ealex/bq76920_board/hardware/bq76920_simple_balance/bq76920_bot.jpg

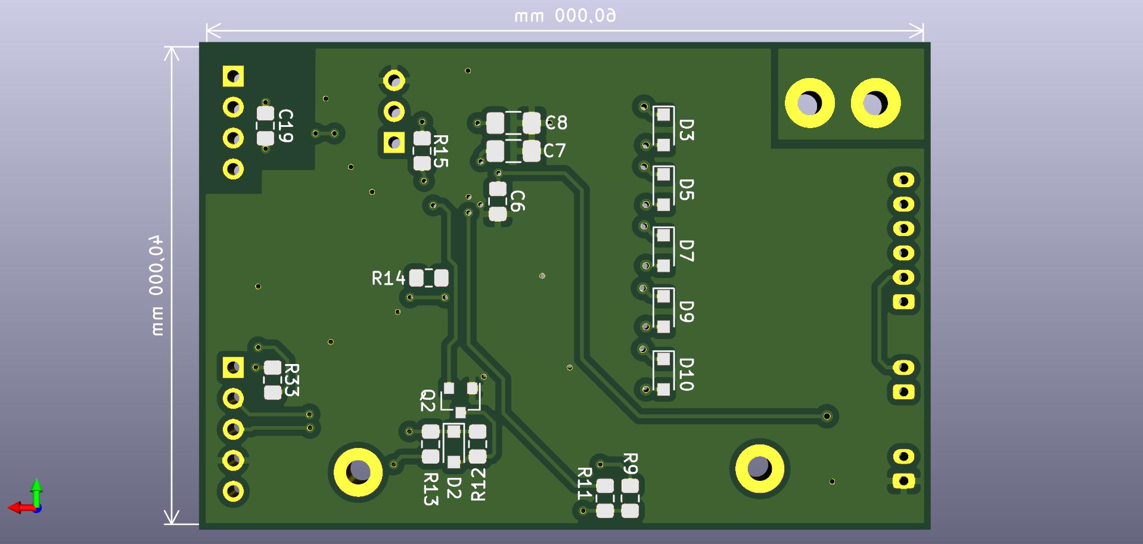
hardware/bq76920_simple_balance/bq76920_bot.jpg
