ealex/bq76920_board/hardware/bq76920_simple_balance/bq76920.html

# BOM Rev

Date

Company

Comment 1

Comment 2

Comment 3

Comment 4

Total Parts

# 86 (Unique 31)

Ref

Qty

Value

Footprint

Datasheet

[C] -

C1 C2 C3

3

100n

Capacitor_SMD:C_0805_2012Metric_Pad1.15x1.40mm_HandSolder

~

C4 C6 C18

3

1n

Capacitor_SMD:C_0805_2012Metric_Pad1.15x1.40mm_HandSolder

~

C5 C7 C8

3

C1206C475K5RACTU

Capacitor_SMD:C_1206_3216Metric_Pad1.42x1.75mm_HandSolder

~

C9 C16 C17 C19

4

100nF

Capacitor_SMD:C_0805_2012Metric_Pad1.15x1.40mm_HandSolder

~

C10 C11 C12 C13 C14 C15

6

220n

Capacitor_SMD:C_0805_2012Metric_Pad1.15x1.40mm_HandSolder

~

[D] -

D1 D2

2

PMEG3010BEA,115

Diode_SMD:D_SOD-323_HandSoldering

https://assets.nexperia.com/documents/data-sheet/1N4148_1N4448.pdf

D3 D5 D7 D9 D10

5

MM3Z5V6ST1G

Diode_SMD:D_SOD-323_HandSoldering

~

D11 D12 D13

3

APTD3216SURCK

Capacitor_SMD:C_1206_3216Metric_Pad1.42x1.75mm_HandSolder

~

[J] -

J1

1

BAT+

bq76920:power_pin

~

J2

1

Conn_01x06

Connector_JST:JST_PH_B6B-PH-K_1x06_P2.00mm_Vertical

~

J3

1

therm

Connector_JST:JST_PH_B2B-PH-K_1x02_P2.00mm_Vertical

~

J4

1

boot_switch

Connector_JST:JST_PH_B2B-PH-K_1x02_P2.00mm_Vertical

~

J5

1

BAT-

bq76920:power_pin

~

J6

1

PACK+

bq76920:power_pin

~

J7

1

PACK-

bq76920:power_pin

~

J8

1

Conn_01x04

Connector_PinHeader_2.54mm:PinHeader_1x04_P2.54mm_Vertical

~

J9

1

Conn_01x05

Connector_PinHeader_2.54mm:PinHeader_1x05_P2.54mm_Vertical

~

J10

1

Conn_01x03

Connector_PinHeader_2.54mm:PinHeader_1x03_P2.54mm_Vertical

~

[Q] -

Q1 Q3

2

PSMN2R6-40YS

Package_TO_SOT_SMD:LFPAK56

Q2

1

SI2337DS-T1-E3

Package_TO_SOT_SMD:SOT-23

~

Q4 Q5 Q6 Q7 Q8

5

NTR3C21NZ

Package_TO_SOT_SMD:SOT-23

~

[R] -

R1 R2 R4 R11 R14 R15 R22 R24 R26 R28 R30 R32 R33 R34 R35 R36

16

10k

Resistor_SMD:R_0805_2012Metric_Pad1.15x1.40mm_HandSolder

~

R3 R6 R8 R10

4

100

Resistor_SMD:R_0805_2012Metric_Pad1.15x1.40mm_HandSolder

~

R5

1

WSHP28185L000FEA

bq76920:WSHP28185L000FEA

~

R7

1

500k

Resistor_SMD:R_0805_2012Metric_Pad1.15x1.40mm_HandSolder

~

R9 R12 R13

3

1Meg

Resistor_SMD:R_0805_2012Metric_Pad1.15x1.40mm_HandSolder

~

R16 R17 R18 R19 R20

5

100

Resistor_SMD:R_1206_3216Metric_Pad1.42x1.75mm_HandSolder

~

R21 R23 R25 R27 R29 R31

6

1k

Resistor_SMD:R_0805_2012Metric_Pad1.15x1.40mm_HandSolder

~

[U] -

U1

1

bq76920

Package_SO:TSSOP-20_4.4x6.5mm_P0.65mm

U2

1

ISO7021

Package_SO:SOIC-8_3.9x4.9mm_P1.27mm

U3

1

STM32L031F4Px

Package_SO:TSSOP-20_4.4x6.5mm_P0.65mm

http://www.st.com/st-web-ui/static/active/en/resource/technical/document/datasheet/DM00140359.pdf

# BOM made with KICAD_BOM_WIZARD (https://github.com/HashDefineElectronics/KiCad_BOM_Wizard) (Generated Mon 03 Feb 2020 01:59:52 PM EET)
