ealex/bq76920_board/documentation/bq769xx/Schematic_10s-Batt-Management-with-Balancing_10s-Batt-Manager-with-on-board-Balancing_20190723125838.pdf

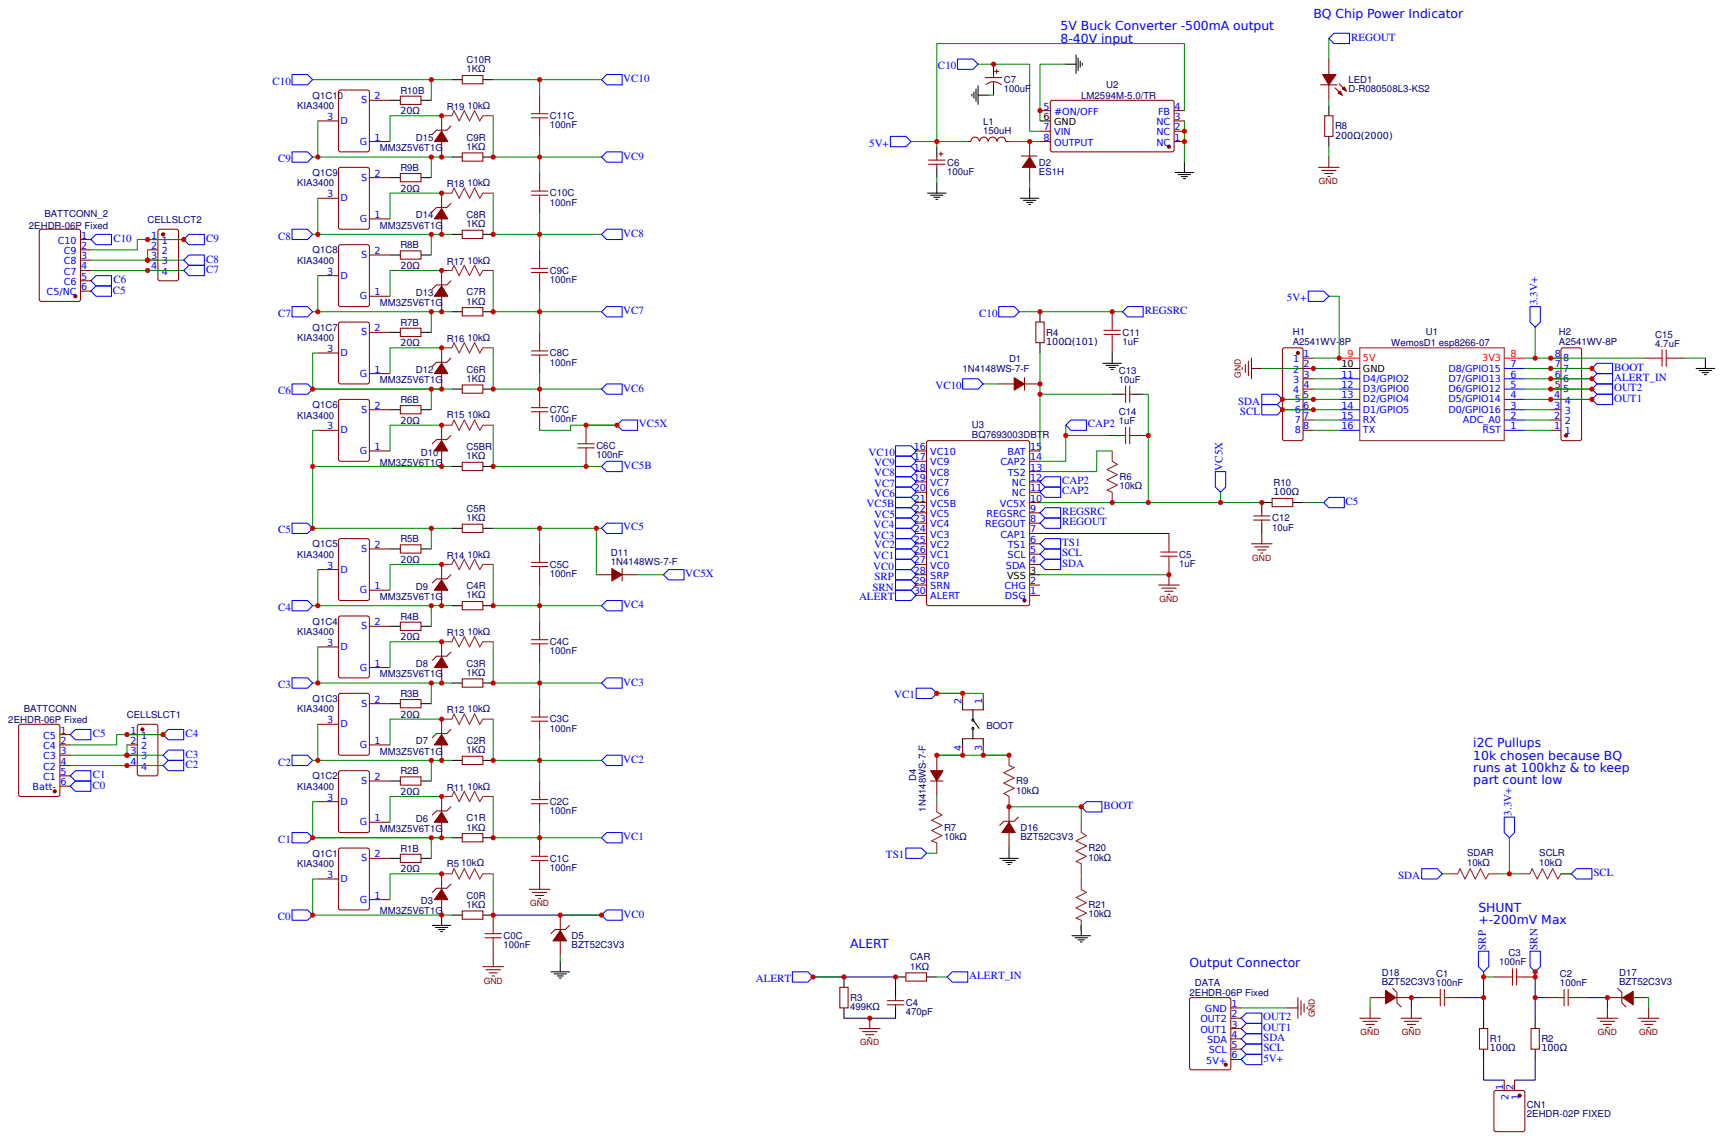
[picture p3: page 1]

BQ Chip Power Indicator
REGOUT

NC 1 NC 2 NC 3 FB 4 #ON/OFF 5
GND 6
VIN 7

i2C Pullups
10k chosen because BQ
runs at 100khz & to keep
part count low
