ealex/bq76920_board/hardware/bq76920_simple_balance/bq76920.pdf

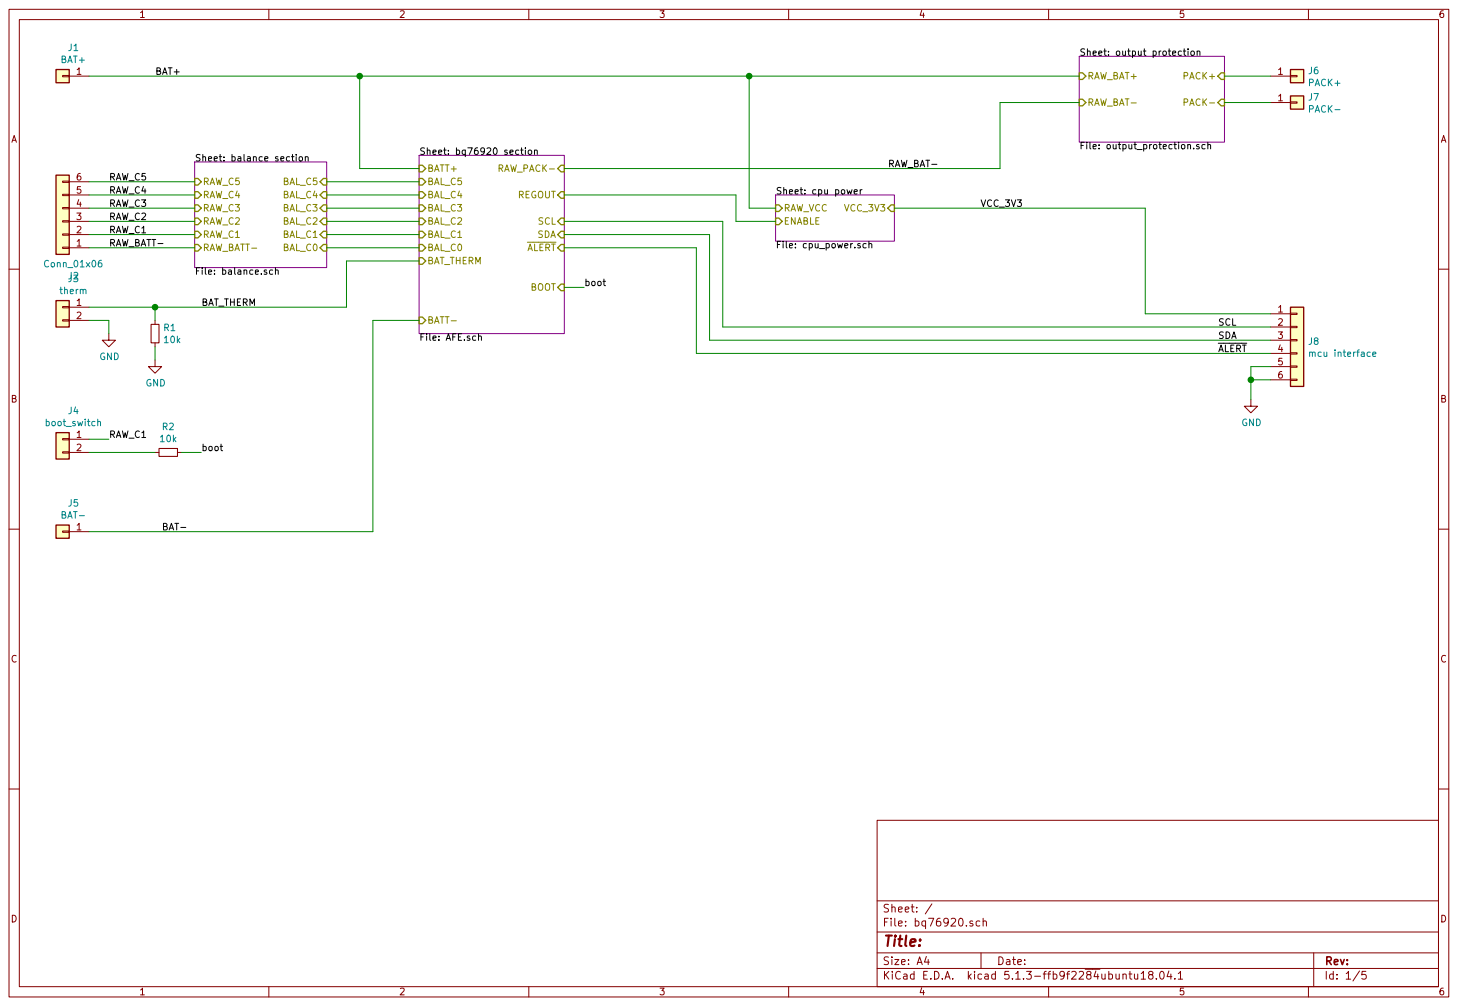
[picture p4: page 1]

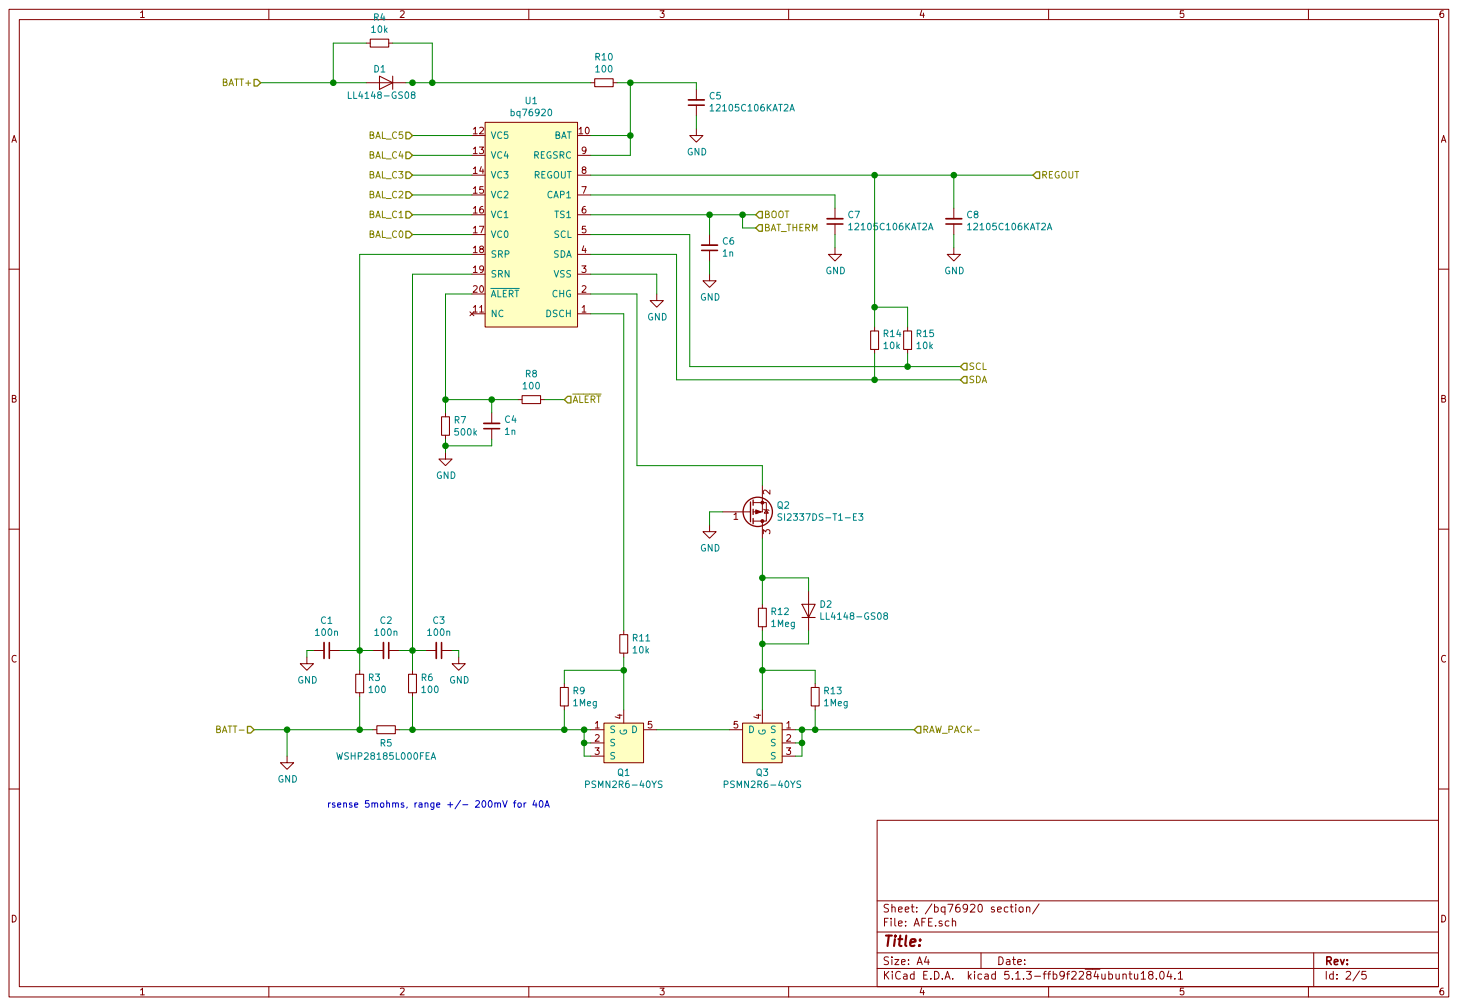
[picture p5: page 2]

Id: 2/5 Title: File: AFE.sch Sheet: /bq76920 section/ GND

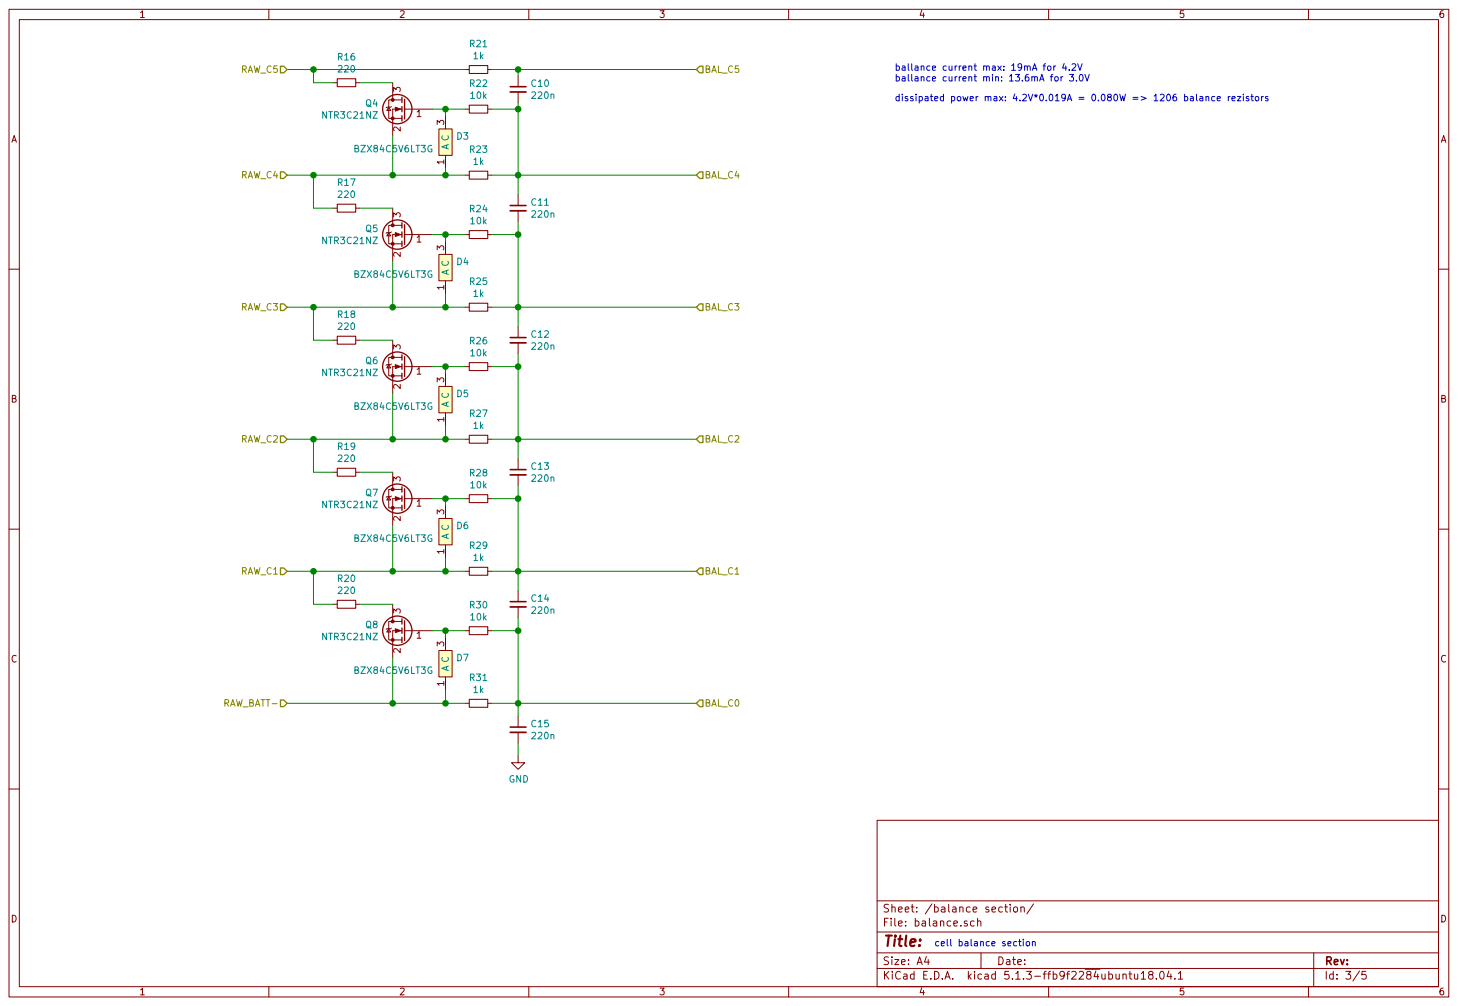
[picture p6: page 3]

dissipated power max: 4.2V*0.019A = 0.080W => 1206 balance rezistors ballance current max: 19mA for 4.2V
ballance current min: 13.6mA for 3.0V

Id: 3/5 Title: File: balance.sch Sheet: /balance section/ C13

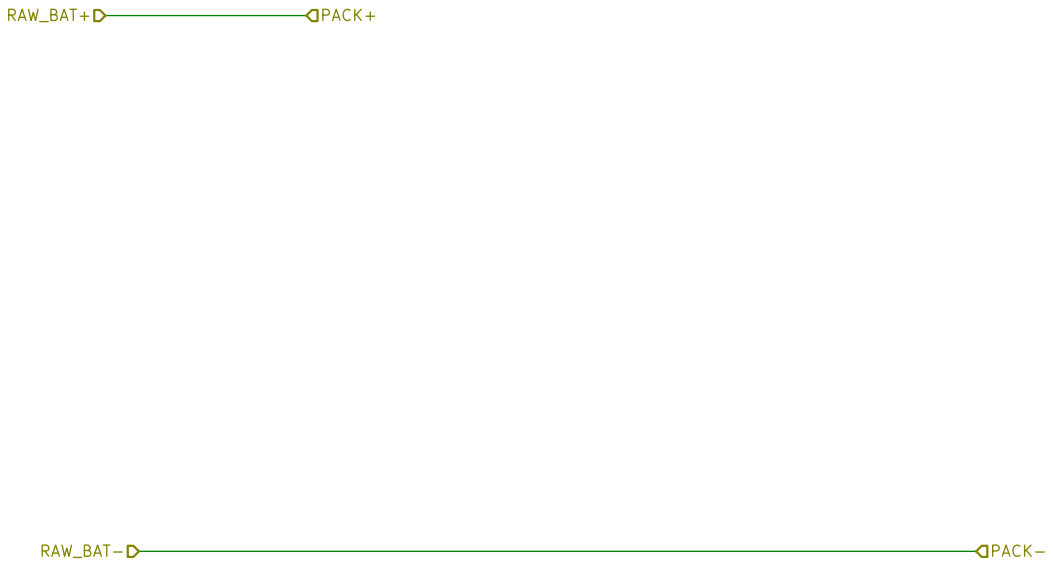
[picture p7: page 4]

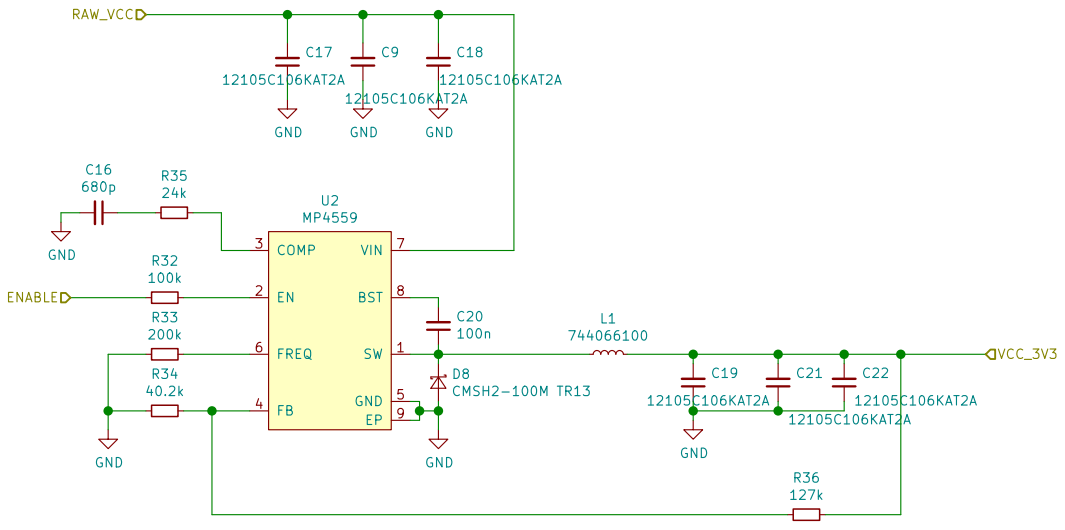
[picture p8: page 5]
