ealex/bq76920_board/hardware/bq76920_simple_balance/bq76920.kicad_pcb

## KiCad design hardware/bq76920_simple_balance/bq76920.kicad_pcb (2021-12-02)

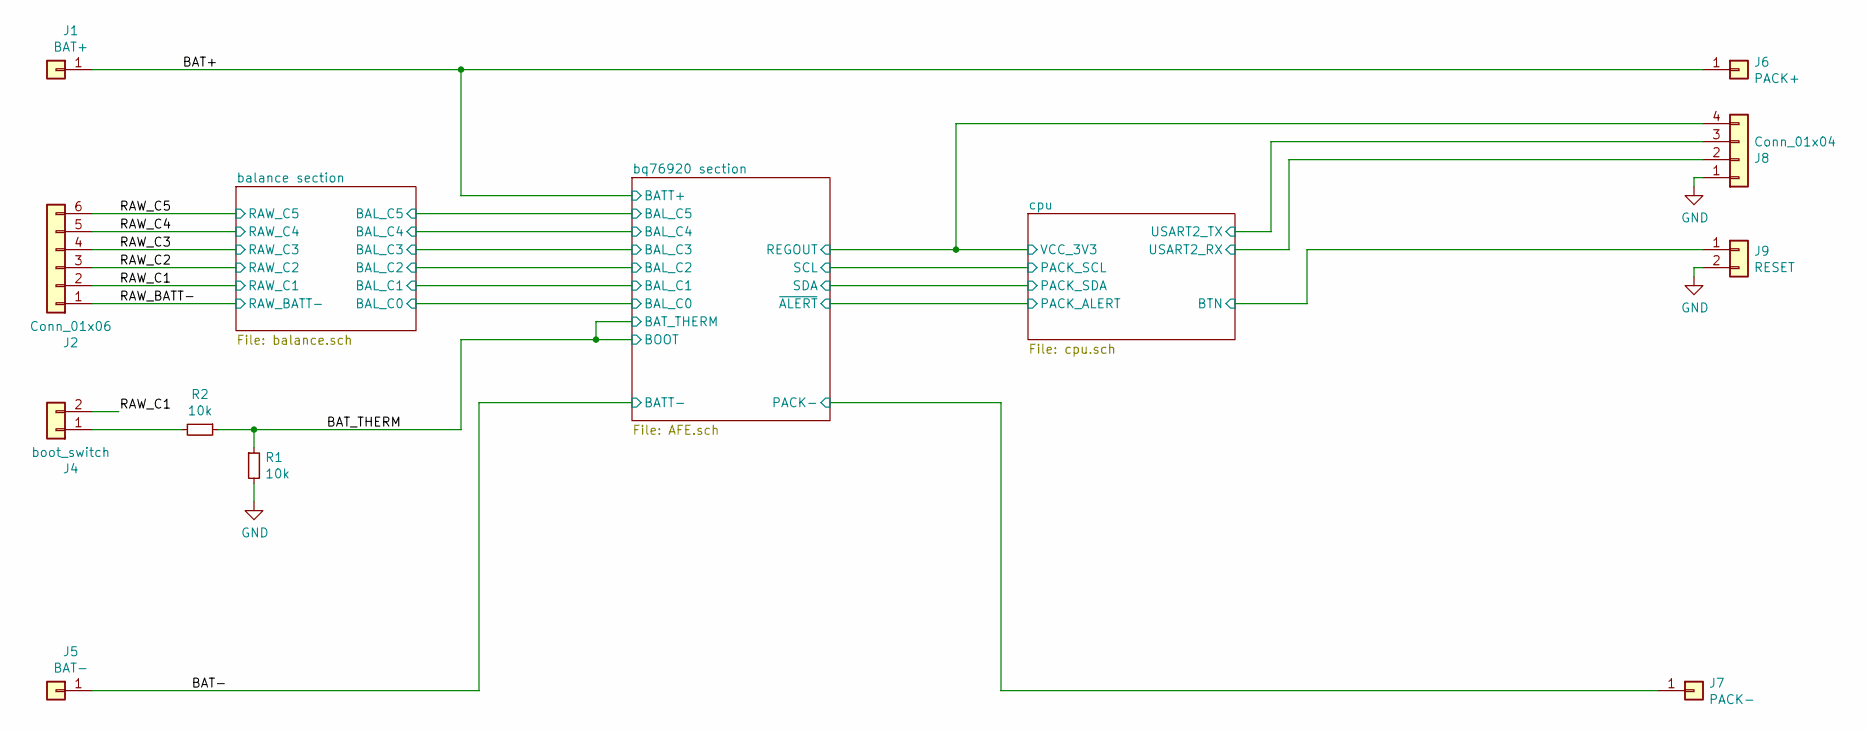
[picture p9: schematic bq76920.sch]

Parts:
J1: BAT+; power_pin
J2: Conn_01x06; JST_PH_B6B-PH-K_1x06_P2.00mm_Vertical
J4: boot_switch; JST_PH_B2B-PH-K_1x02_P2.00mm_Vertical
J5: BAT-; power_pin
J6: PACK+; power_pin
J7: PACK-; power_pin
J8: Conn_01x04; JST_PH_B4B-PH-K_1x04_P2.00mm_Vertical
J9: RESET; JST_PH_B2B-PH-K_1x02_P2.00mm_Vertical
R1, R2: 10k; R_0805_2012Metric_Pad1.15x1.40mm_HandSolder

Connections:
+3V3: J8.4; also elsewhere on the board
/BAT+: J1.1, J6.1; also elsewhere on the board
/BAT-: J5.1; also elsewhere on the board
/BAT_THERM: R1.1, R2.1; also elsewhere on the board
/RAW_BATT-: J2.1; also elsewhere on the board
/RAW_C1: J2.2, J4.2; also elsewhere on the board
/RAW_C2: J2.3; also elsewhere on the board
/RAW_C3: J2.4; also elsewhere on the board
/RAW_C4: J2.5; also elsewhere on the board
/RAW_C5: J2.6; also elsewhere on the board
/bq76920 section/PACK-: J7.1; also elsewhere on the board
/cpu/BTN: J9.1; also elsewhere on the board
/cpu/USART2_RX: J8.2; also elsewhere on the board
/cpu/USART2_TX: J8.3; also elsewhere on the board
GND: J8.1, J9.2, R1.2; also elsewhere on the board
unnamed: J4.1, R2.2

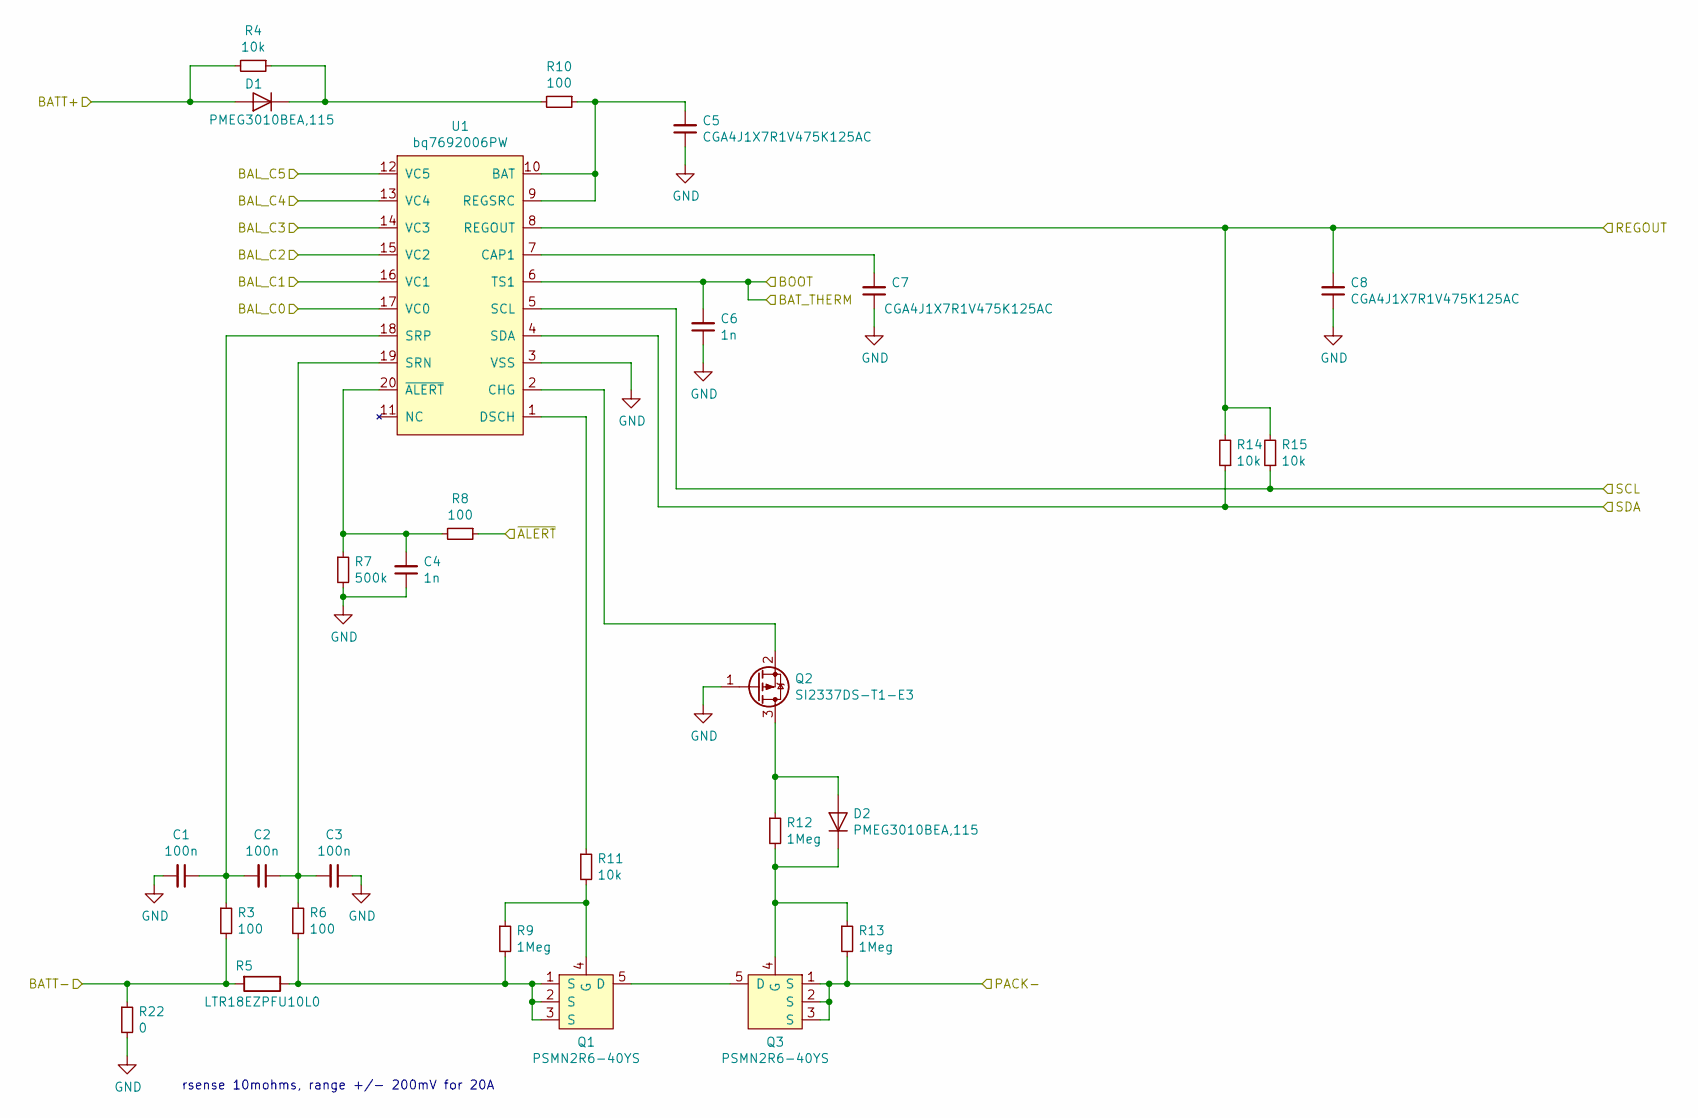
[picture p10: schematic AFE.sch]

Parts:
C1, C2, C3: 100n; C_0805_2012Metric_Pad1.15x1.40mm_HandSolder
C4, C6: 1n; C_0805_2012Metric_Pad1.15x1.40mm_HandSolder
C5, C7, C8: CGA4J1X7R1V475K125AC; C_0805_2012Metric
D1, D2: PMEG3010BEA,115; D_SOD-323_HandSoldering
Q1, Q3: PSMN2R6-40YS; LFPAK56
Q2: SI2337DS-T1-E3; SOT-23
R3, R6, R8, R10: 100; R_0805_2012Metric_Pad1.15x1.40mm_HandSolder
R4, R11, R14, R15: 10k; R_0805_2012Metric_Pad1.15x1.40mm_HandSolder
R5: LTR18EZPFU10L0; R_0612_1632Metric
R7: 500k; R_0805_2012Metric_Pad1.15x1.40mm_HandSolder
R9, R12, R13: 1Meg; R_0805_2012Metric_Pad1.15x1.40mm_HandSolder
R22: 0; R_0805_2012Metric_Pad1.15x1.40mm_HandSolder
U1: bq7692006PW; TSSOP-20_4.4x6.5mm_P0.65mm

Connections:
+3V3: C8.2, R14.2, R15.2, U1.8 (REGOUT); also elsewhere on the board
/BAT+: D1.2 (A), R4.2; also elsewhere on the board
/BAT-: R3.2, R5.2, R22.1; also elsewhere on the board
/BAT_THERM: C6.2, U1.6 (TS1); also elsewhere on the board
/balance section/BAL_C0: U1.17 (VC0); also elsewhere on the board
/balance section/BAL_C1: U1.16 (VC1); also elsewhere on the board
/balance section/BAL_C2: U1.15 (VC2); also elsewhere on the board
/balance section/BAL_C3: U1.14 (VC3); also elsewhere on the board
/balance section/BAL_C4: U1.13 (VC4); also elsewhere on the board
/balance section/BAL_C5: U1.12 (VC5); also elsewhere on the board
/bq76920 section/PACK-: Q3.1 (S), Q3.2 (S), Q3.3 (S), R13.2; also elsewhere on the board
/cpu/PACK_ALERT: R8.1; also elsewhere on the board
/cpu/PACK_SCL: R15.1, U1.5 (SCL); also elsewhere on the board
/cpu/PACK_SDA: R14.1, U1.4 (SDA); also elsewhere on the board
GND: C1.2, C3.1, C4.1, C5.1, C6.1, C7.1, C8.1, Q2.1 (G), R7.2, R22.2, U1.3 (VSS); also elsewhere on the board
unnamed: C1.1, C2.2, R3.1, U1.18 (SRP)
unnamed: C2.1, C3.2, R6.1, U1.19 (SRN)
unnamed: C4.2, R7.1, R8.2, U1.20 (~ALERT)
unnamed: C5.2, R10.1, U1.9 (REGSRC), U1.10 (BAT)
unnamed: C7.2, U1.7 (CAP1)
unnamed: D1.1 (K), R4.1, R10.2
unnamed: D2.1 (K), Q3.4 (G), R12.2, R13.1
unnamed: D2.2 (A), Q2.3 (D), R12.1
unnamed: Q1.1 (S), Q1.2 (S), Q1.3 (S), R5.1, R6.2, R9.2
unnamed: Q1.4 (G), R9.1, R11.2
unnamed: Q1.5 (D), Q3.5 (D)
unnamed: Q2.2 (S), U1.2 (CHG)
unnamed: R11.1, U1.1 (DSCH)

Notes on the sheet:
rsense 10mohms, range +/- 200mV for 20A

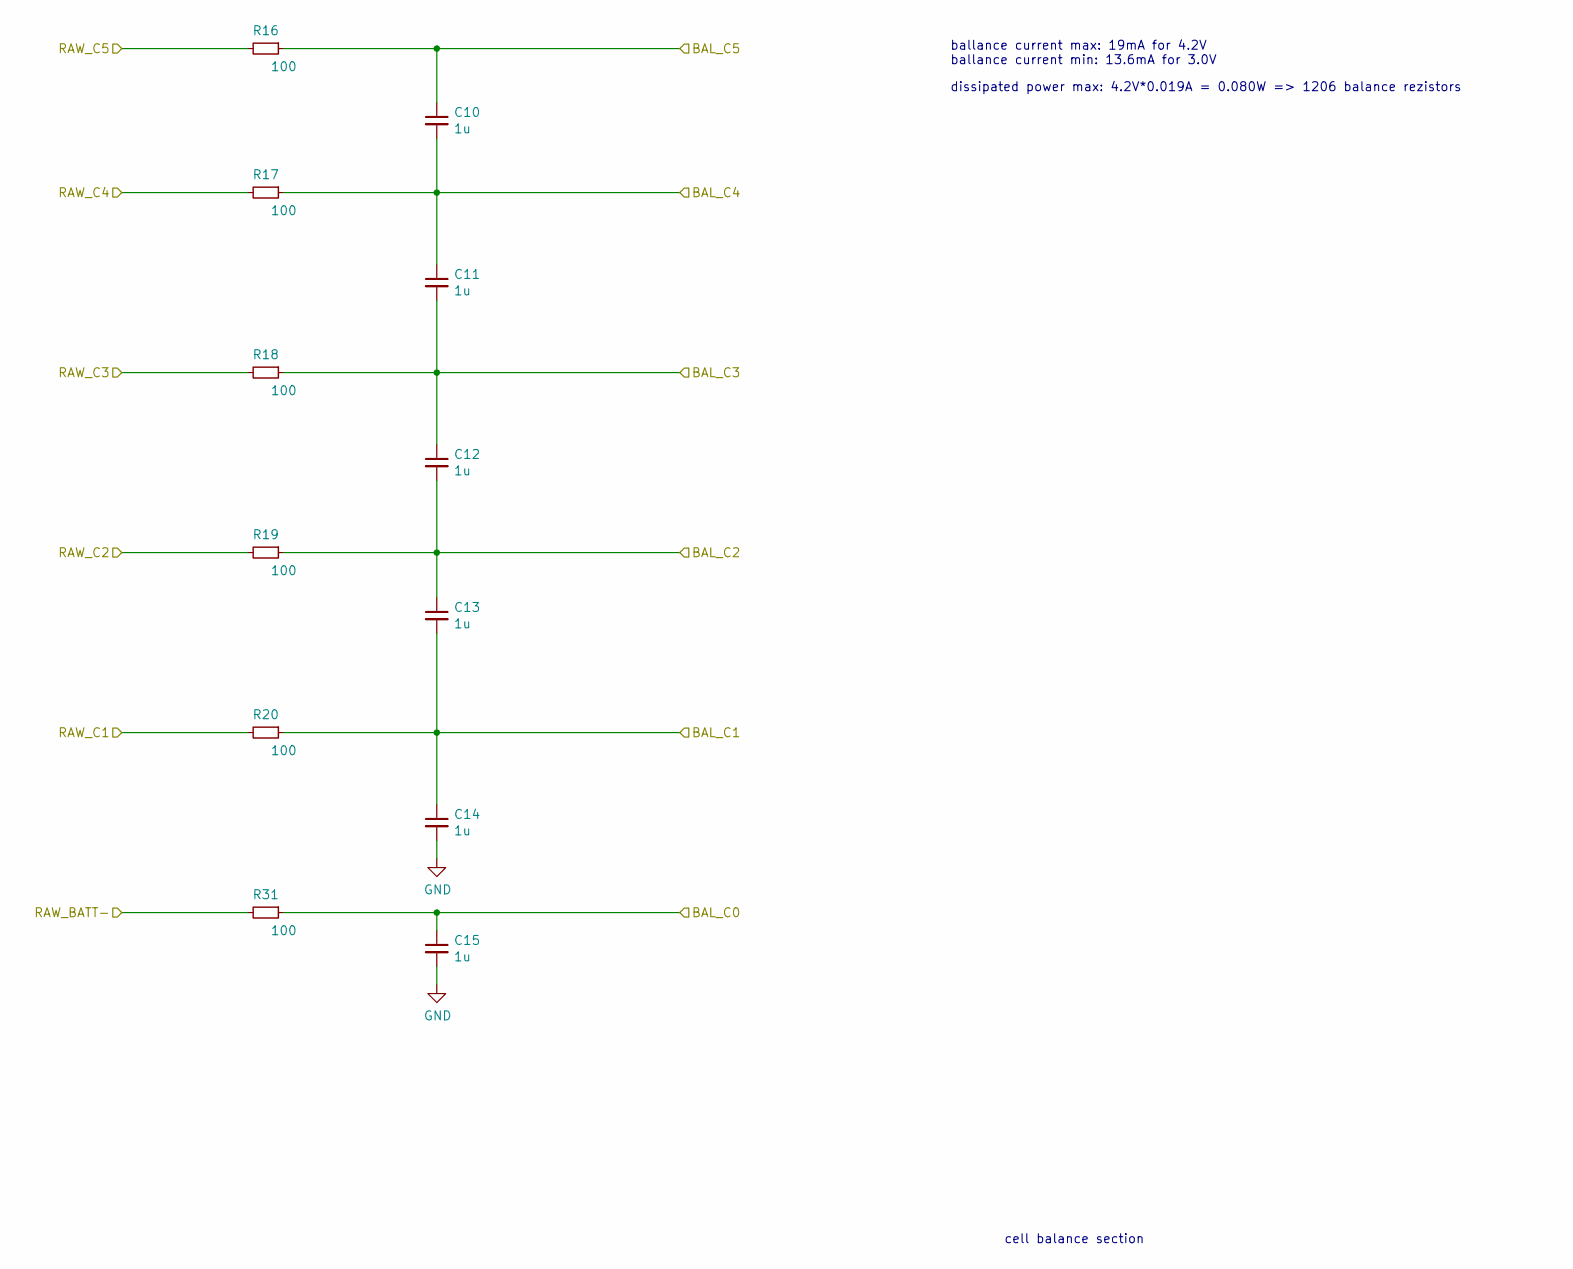
[picture p11: schematic balance.sch]

Parts:
C10, C11, C12, C13, C14, C15: 1u; C_0805_2012Metric_Pad1.15x1.40mm_HandSolder
R16, R17, R18, R19, R20, R31: 100; R_1206_3216Metric

Connections:
/RAW_BATT-: R31.2; also elsewhere on the board
/RAW_C1: R20.2; also elsewhere on the board
/RAW_C2: R19.2; also elsewhere on the board
/RAW_C3: R18.2; also elsewhere on the board
/RAW_C4: R17.2; also elsewhere on the board
/RAW_C5: R16.2; also elsewhere on the board
/balance section/BAL_C0: C15.1, R31.1; also elsewhere on the board
/balance section/BAL_C1: C13.2, C14.1, R20.1; also elsewhere on the board
/balance section/BAL_C2: C12.2, C13.1, R19.1; also elsewhere on the board
/balance section/BAL_C3: C11.2, C12.1, R18.1; also elsewhere on the board
/balance section/BAL_C4: C10.2, C11.1, R17.1; also elsewhere on the board
/balance section/BAL_C5: C10.1, R16.1; also elsewhere on the board
GND: C14.2, C15.2; also elsewhere on the board

Notes on the sheet:
ballance current max: 19mA for 4.2V ballance current min: 13.6mA for 3.0V
dissipated power max: 4.2V*0.019A = 0.080W => 1206 balance rezistors
cell balance section

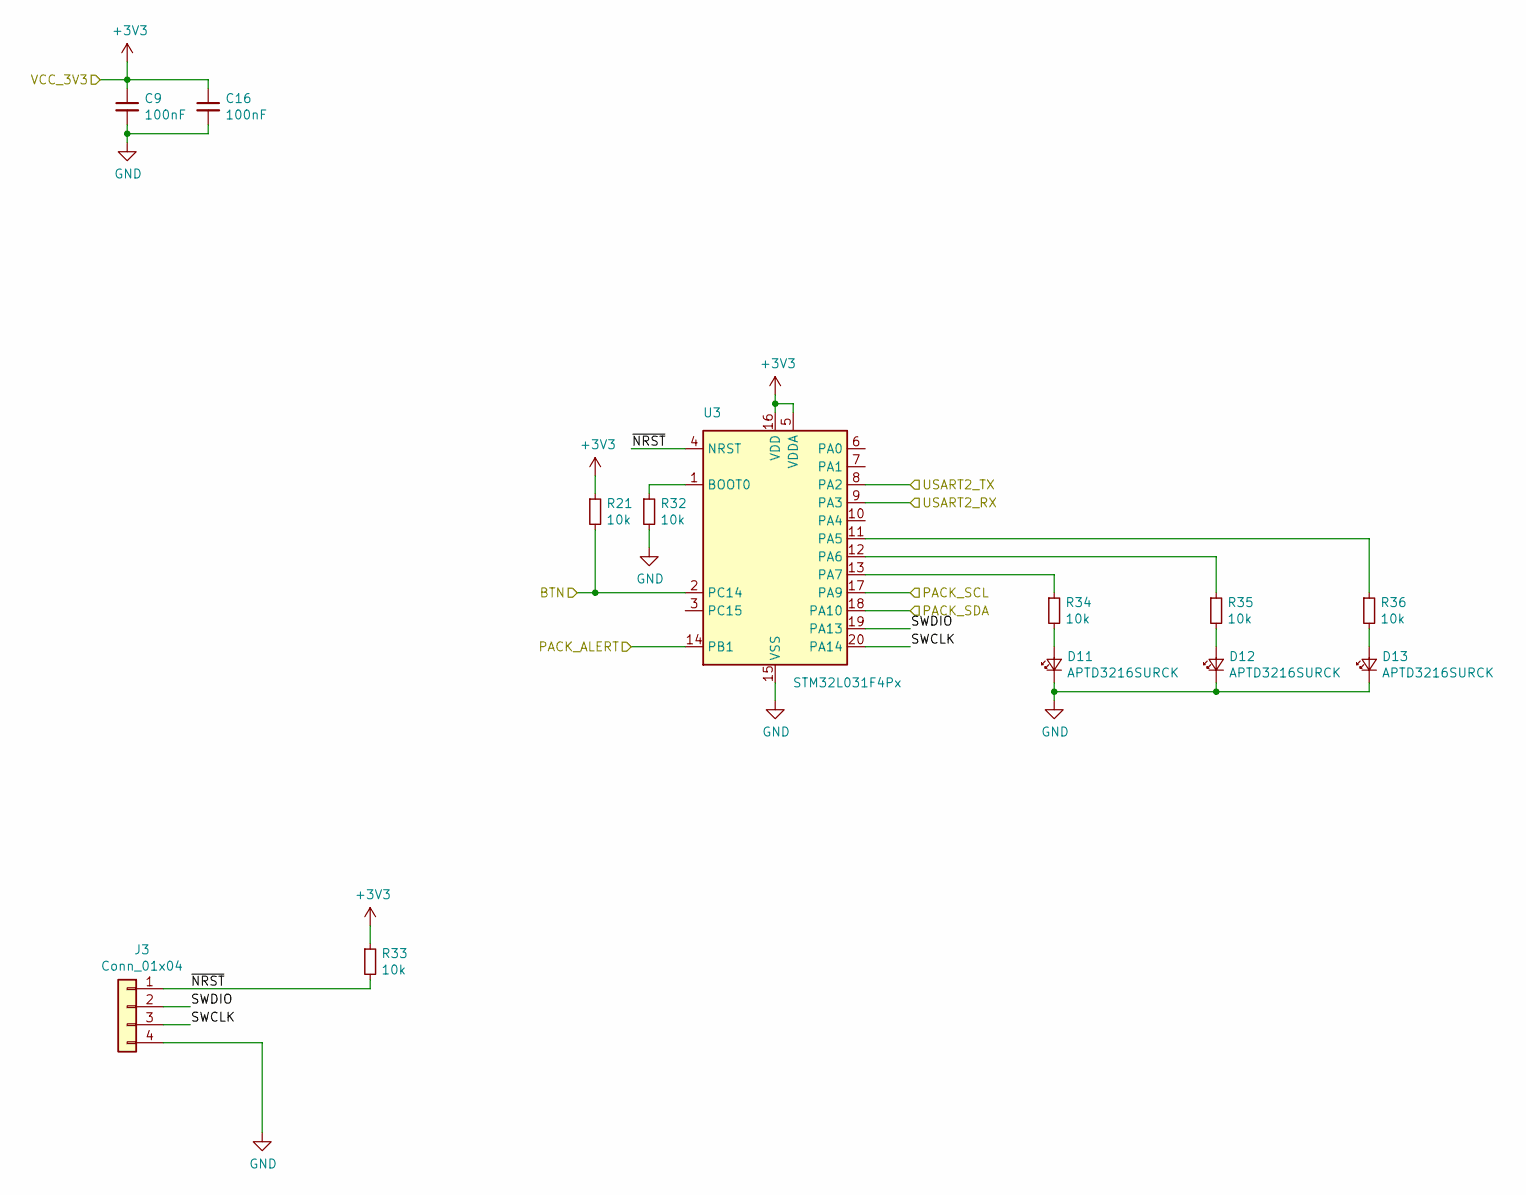
[picture p12: schematic cpu.sch]

Parts:
C9, C16: 100nF; C_0805_2012Metric_Pad1.15x1.40mm_HandSolder
D11, D12, D13: APTD3216SURCK; C_1206_3216Metric_Pad1.42x1.75mm_HandSolder
J3: Conn_01x04; JST_PH_B4B-PH-K_1x04_P2.00mm_Vertical
R21, R32, R33, R34, R35, R36: 10k; R_0805_2012Metric_Pad1.15x1.40mm_HandSolder
U3: STM32L031F4Px; TSSOP-20_4.4x6.5mm_P0.65mm

Connections:
+3V3: C9.1, C16.1, R21.1, R33.1, U3.5 (VDDA), U3.16 (VDD); also elsewhere on the board
/cpu/BTN: R21.2, U3.2 (PC14); also elsewhere on the board
/cpu/PACK_ALERT: U3.14 (PB1); also elsewhere on the board
/cpu/PACK_SCL: U3.17 (PA9); also elsewhere on the board
/cpu/PACK_SDA: U3.18 (PA10); also elsewhere on the board
/cpu/SWCLK: J3.3, U3.20 (PA14)
/cpu/SWDIO: J3.2, U3.19 (PA13)
/cpu/USART2_RX: U3.9 (PA3); also elsewhere on the board
/cpu/USART2_TX: U3.8 (PA2); also elsewhere on the board
/cpu/~NRST: J3.1, R33.2, U3.4 (NRST)
GND: C9.2, C16.2, D11.1 (K), D12.1 (K), D13.1 (K), J3.4, R32.2, U3.15 (VSS); also elsewhere on the board
unnamed: D11.2 (A), R34.2
unnamed: D12.2 (A), R35.2
unnamed: D13.2 (A), R36.2
unnamed: R32.1, U3.1 (BOOT0)
unnamed: R34.1, U3.13 (PA7)
unnamed: R35.1, U3.12 (PA6)
unnamed: R36.1, U3.11 (PA5)

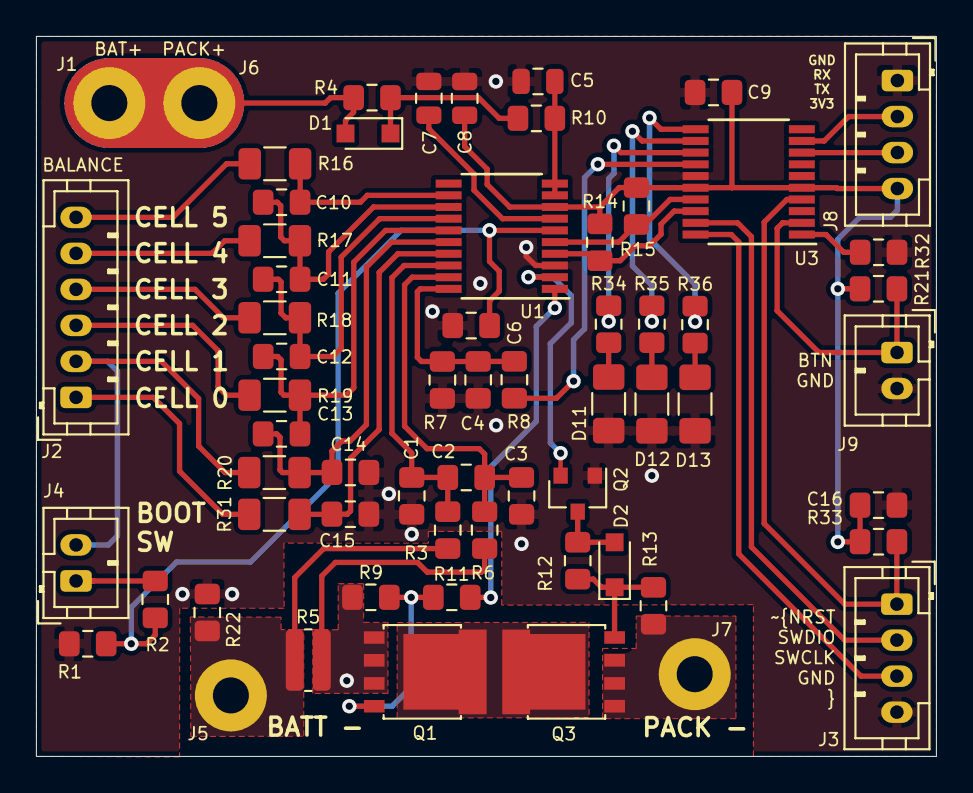
[picture p13: board bq76920.kicad_pcb from above]

Board: 2 copper layers, 50.0 x 40.0 mm, 63 parts (0 on the bottom side), 48 nets.
