ealex/bq76920_board/software/cube/Core/Src/main.c

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
/* Includes ------------------------------------------------------------------*/
#include "main.h"

/* USER CODE BEGIN Includes */
#include "BQ769x0.h"
#include "comm.h"
/* USER CODE END Includes */

/* USER CODE BEGIN PD */
#define BUTTON_DEBOUNCE_LIMIT ((uint32_t)10)
/* USER CODE END PD */


/* USER CODE BEGIN PV */
static afe_config afeConfig;
static condensed_afe_data afeData;
/* USER CODE END PV */

void SystemClock_Config(void);
static void MX_GPIO_Init(void);
static void MX_I2C1_Init(void);
static void MX_USART2_UART_Init(void);
/**
  * @brief  The application entry point.
  * @retval int
  */
int main(void)
{
  /* USER CODE BEGIN 1 */
	uint32_t button_debounce;


  /* USER CODE END 1 */

  /* MCU Configuration--------------------------------------------------------*/

  /* Reset of all peripherals, Initializes the Flash interface and the Systick. */

  LL_APB2_GRP1_EnableClock(LL_APB2_GRP1_PERIPH_SYSCFG);
  LL_APB1_GRP1_EnableClock(LL_APB1_GRP1_PERIPH_PWR);

  /* System interrupt init*/

  /* Configure the system clock */
  SystemClock_Config();

  /* Initialize all configured peripherals */
  MX_GPIO_Init();
  MX_I2C1_Init();
  MX_USART2_UART_Init();
  /* USER CODE BEGIN 2 */

  afeConfig.enabled_cells=0b00010111;
  // current limit settings
  afeConfig.range = threshold_upper;
  afeConfig.sc_delay = scd_400_us;
  afeConfig.sc_voltage=scd_111_56_mv;
  afeConfig.oc_delay=ocd_8_ms;
  afeConfig.oc_voltage=ocd_44_22_mv;
  afeConfig.shuntValue=5; // 5 mOhms
  afeConfig.chargeCurrent_mA = 4000;

  // voltage limit settings
  afeConfig.uv_delay=uvd_4_s;
  afeConfig.uvLimit=0xFF;
  afeConfig.ov_delay=ovd_2_s;
  afeConfig.ovLimit=0xAA;

  // generic pack configuration
  afeConfig.pack_max_voltage = 16400;
  afeConfig.cell_bal_voltage = 4100;

  if(0==bqInit(I2C1, &afeData, &afeConfig)) {
	  // ERROR
	  LL_GPIO_SetOutputPin(LED0_GPIO_Port, LED0_Pin);
	  LL_GPIO_SetOutputPin(LED1_GPIO_Port, LED1_Pin);
	  LL_GPIO_SetOutputPin(LED2_GPIO_Port, LED2_Pin);
	  asm volatile ("bkpt 0");
  } else {
	  bqEnableAll();
  }

  commInit(USART2, &afeData, &afeConfig);
  /* USER CODE END 2 */

  /* Infinite loop */
  /* USER CODE BEGIN WHILE */
  while (1) {
    /* USER CODE END WHILE */

    /* USER CODE BEGIN 3 */
	  // handle AFE
	  if(LL_GPIO_IsInputPinSet(SIGNAL_GPIO_Port,SIGNAL_Pin)) {
		  LL_GPIO_SetOutputPin(LED0_GPIO_Port, LED0_Pin);

		  // AFE event signaled,
		  bqAct();
		  LL_GPIO_ResetOutputPin(LED1_GPIO_Port, LED1_Pin);
		  LL_GPIO_ResetOutputPin(LED2_GPIO_Port, LED2_Pin);
		  if(0b00001100&afeData.status_reg) { // voltage problem
			  LL_GPIO_SetOutputPin(LED1_GPIO_Port, LED1_Pin);
		  } else if(0b00000011&afeData.status_reg) { // discharge current problem
			  LL_GPIO_SetOutputPin(LED2_GPIO_Port, LED2_Pin);
		  } else if (0b11000000&afeData.status_reg) { // charge current problem
			  LL_GPIO_SetOutputPin(LED1_GPIO_Port, LED1_Pin);
			  LL_GPIO_SetOutputPin(LED2_GPIO_Port, LED2_Pin);
		  }

		  // handle the balancing system
		  bqBalance();

		  // handle the communication system
		  commAct();

		  // check the button and decide what needs to happen
		  if(LL_GPIO_IsInputPinSet(BUTTON_GPIO_Port, BUTTON_Pin)) {
			  button_debounce = 0;
		  } else {
			  if(button_debounce < BUTTON_DEBOUNCE_LIMIT) {
				  button_debounce ++;
			  } else if ( BUTTON_DEBOUNCE_LIMIT == button_debounce ) {
				  button_debounce ++;
				  // act on the button
				  if(0b11001111&afeData.status_reg) {
					  // reset error status if there's a problem
					  bqDisableAll();
					  bqResetStatus();
					  bqEnableAll();
				  } else {
					  // start the balance algo
					  afeData.balStatus=1;
				  }
			  } else {
				  button_debounce = button_debounce ;
			  }
		  }

		  LL_GPIO_ResetOutputPin(LED0_GPIO_Port, LED0_Pin);
	  }
  }
  /* USER CODE END 3 */
}

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
