ealex/bq76920_board/software/cube/Core/Inc/main.h

#define BUTTON_Pin LL_GPIO_PIN_14
#define BUTTON_GPIO_Port GPIOC
#define LED2_Pin LL_GPIO_PIN_4
#define LED2_GPIO_Port GPIOA
#define LED0_Pin LL_GPIO_PIN_5
#define LED0_GPIO_Port GPIOA
#define LED1_Pin LL_GPIO_PIN_6
#define LED1_GPIO_Port GPIOA
#define SIGNAL_Pin LL_GPIO_PIN_1
#define SIGNAL_GPIO_Port GPIOB
#define NVIC_PRIORITYGROUP_0         ((uint32_t)0x00000007) /*!< 0 bit  for pre-emption priority,
#define NVIC_PRIORITYGROUP_1         ((uint32_t)0x00000006) /*!< 1 bit  for pre-emption priority,
#define NVIC_PRIORITYGROUP_2         ((uint32_t)0x00000005) /*!< 2 bits for pre-emption priority,
#define NVIC_PRIORITYGROUP_3         ((uint32_t)0x00000004) /*!< 3 bits for pre-emption priority,
#define NVIC_PRIORITYGROUP_4         ((uint32_t)0x00000003) /*!< 4 bits for pre-emption priority,
