ealex/bq76920_board/(commit log)

2020-01-06 add all files over here, from the locally developed project
    [AFE.sch, balance.sch, bq76920.csv, bq76920.kicad_pcb, bq76920.sch, cpu.sch, cpu_power.sch, output_protection.sch]
2020-01-06 remove old project data
    [AFE.sch, balance.sch, bq76920.sch]
2020-01-06 update cpu and reduce BOM
    [AFE.sch, balance.sch, bq76920.sch, cpu.sch]
2020-01-06 update bom
    [AFE.sch, cpu.sch]
2020-01-07 update BOM, arrange some files
2020-01-07 clean up, adnotate, footprints
    [AFE.sch, balance.sch, bq76920.kicad_pcb, bq76920.sch, cpu.sch]
2020-01-08 final pcb version
    [balance.sch, bq76920.sch, cpu.sch]
2020-01-08 create manufacture data, start prototype production
    [bq76920-B_Cu.gbr, bq76920-B_Mask.gbr, bq76920-B_SilkS.gbr, bq76920-Edge_Cuts.gbr, bq76920-F_Cu.gbr, bq76920-F_Mask.gbr, bq76920-F_SilkS.gbr, bq76920-Margin.gbr]
2020-02-29 add STM32 cube based version
2020-07-30 update fw
    [AFE.sch, balance.sch, bq76920.sch, cpu.sch, stm32f1.cfg]
2021-12-02 simple balance board, 1 sided version
    [AFE.sch, balance.sch, bq76920.csv, bq76920.kicad_pcb, bq76920.sch, cpu.sch, cpu_power.sch, output_protection.sch]
